SeerLikeJazz/Libuart-peripheral-EEG/(threads)

Thread 1 (2024-11-12):

Request to add PCB designs

xinterface, 2024-11-12:
Hi 👋,
I recently came across your project and wanted to ask if you’d be able to share the PCB design in the same folder. If possible, could you also let me know which software you used? And if you still have the project files, would you mind adding those too?

I’m currently learning KiCad—still getting the hang of it, but making progress!

If you have some time to connect in the future, I would love to chat with you about your project.

Thank you so much! ✌️
