SeerLikeJazz/Libuart-peripheral-EEG/Hardware/Schematic_nrf52832_2022-09-26.pdf

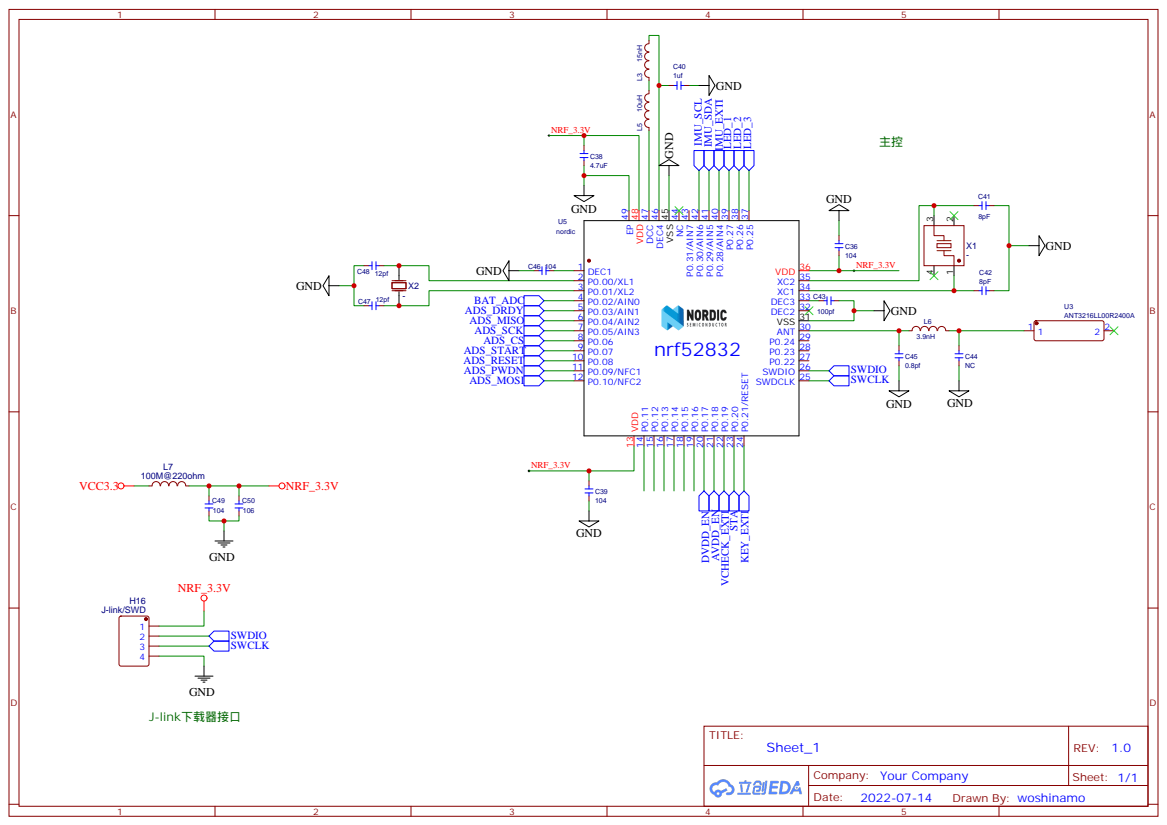
[picture p6: page 1]

P0.25 37 P0.26 38 P0.27 39 P0.28/AIN4 40 P0.29/AIN5 41 P0.30/AIN6 42 P0.31/AIN7 43 NC 44 VSS 45 DEC4 46 DCC 47 VDD 48 EP 49

# Vcheck画错了，应该是接入5V

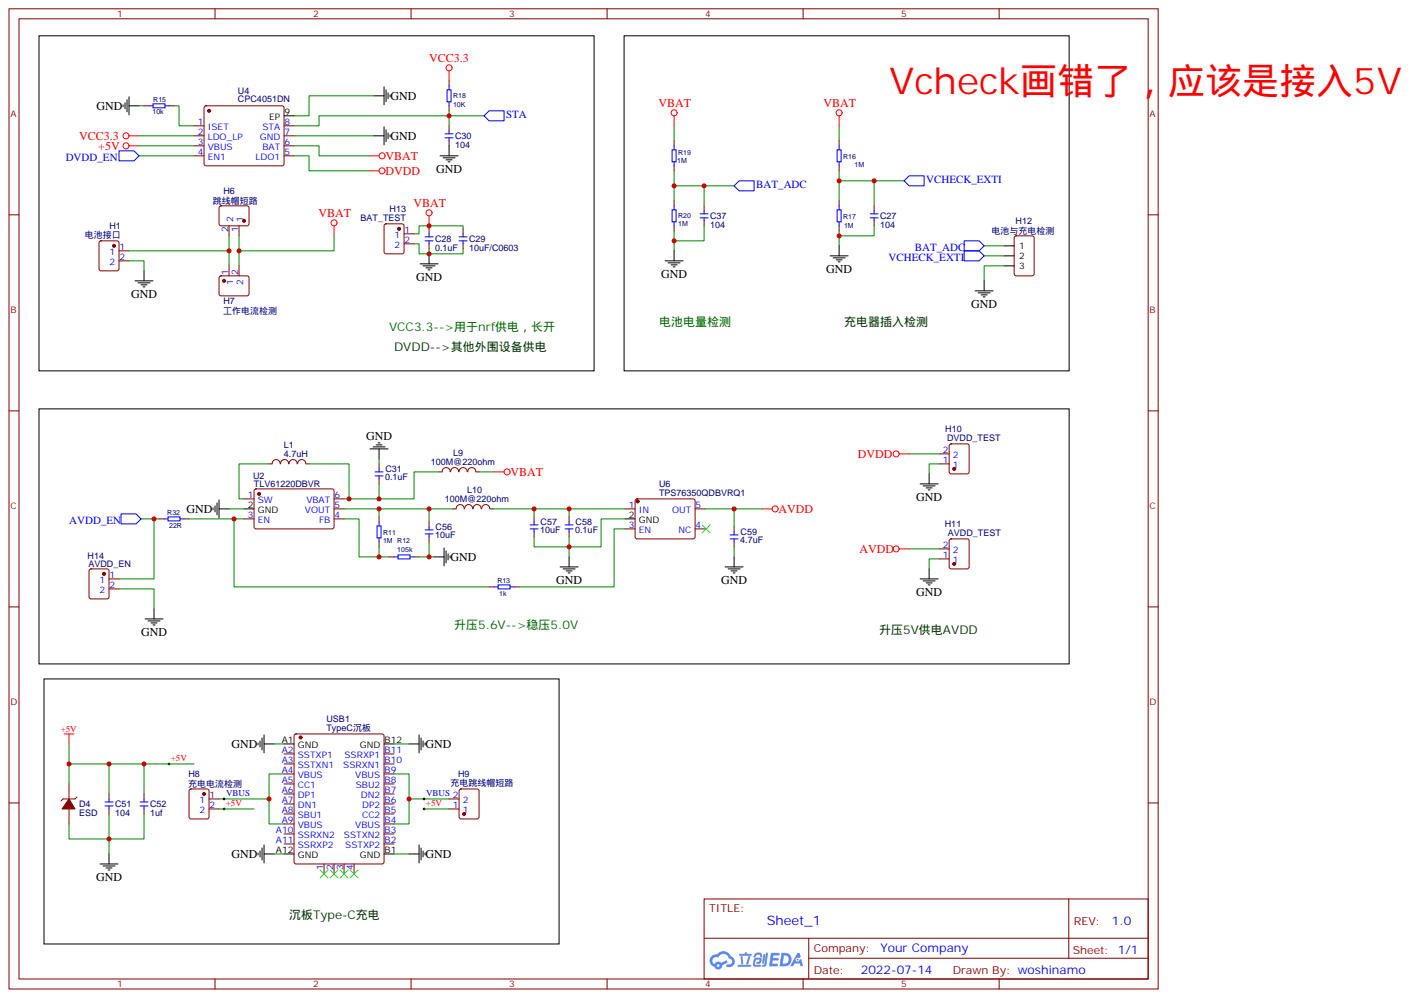
[picture p7: page 2]

GND B1 GND A12 SSRXP2 A11 SSRXN2 A10 VBUS A9 SBU1 A8 DN1 A7 DP1 A6 CC1 A5 VBUS A4 SSTXN1 A3 SSTXP1 A2 GND A1

AVSS 32 DGND 33 DIN 34 PWDN# 35 RESET# 36 CLK 37 START 38 CS# 39 SCLK 40 DAISY_IN 41 GPIO1 42 DOUT 43 GPIO2 44 GPIO3 45 GPIO4 46 DRDY# 47 DVDD 48 DGND 49 DVDD 50 DGND 51 CLKSEL 52 AVSS1 53 AVDD1 54 VCAP3 55 AVDD 56 AVSS 57 AVSS 58 AVDD 59 BIASREF 60 BIASINV 61 BIASIN 62 BIASOUT 63 RESERVED 64

## BIASINV BIASIN-->Filter or FeedThrough -->BIASOUT

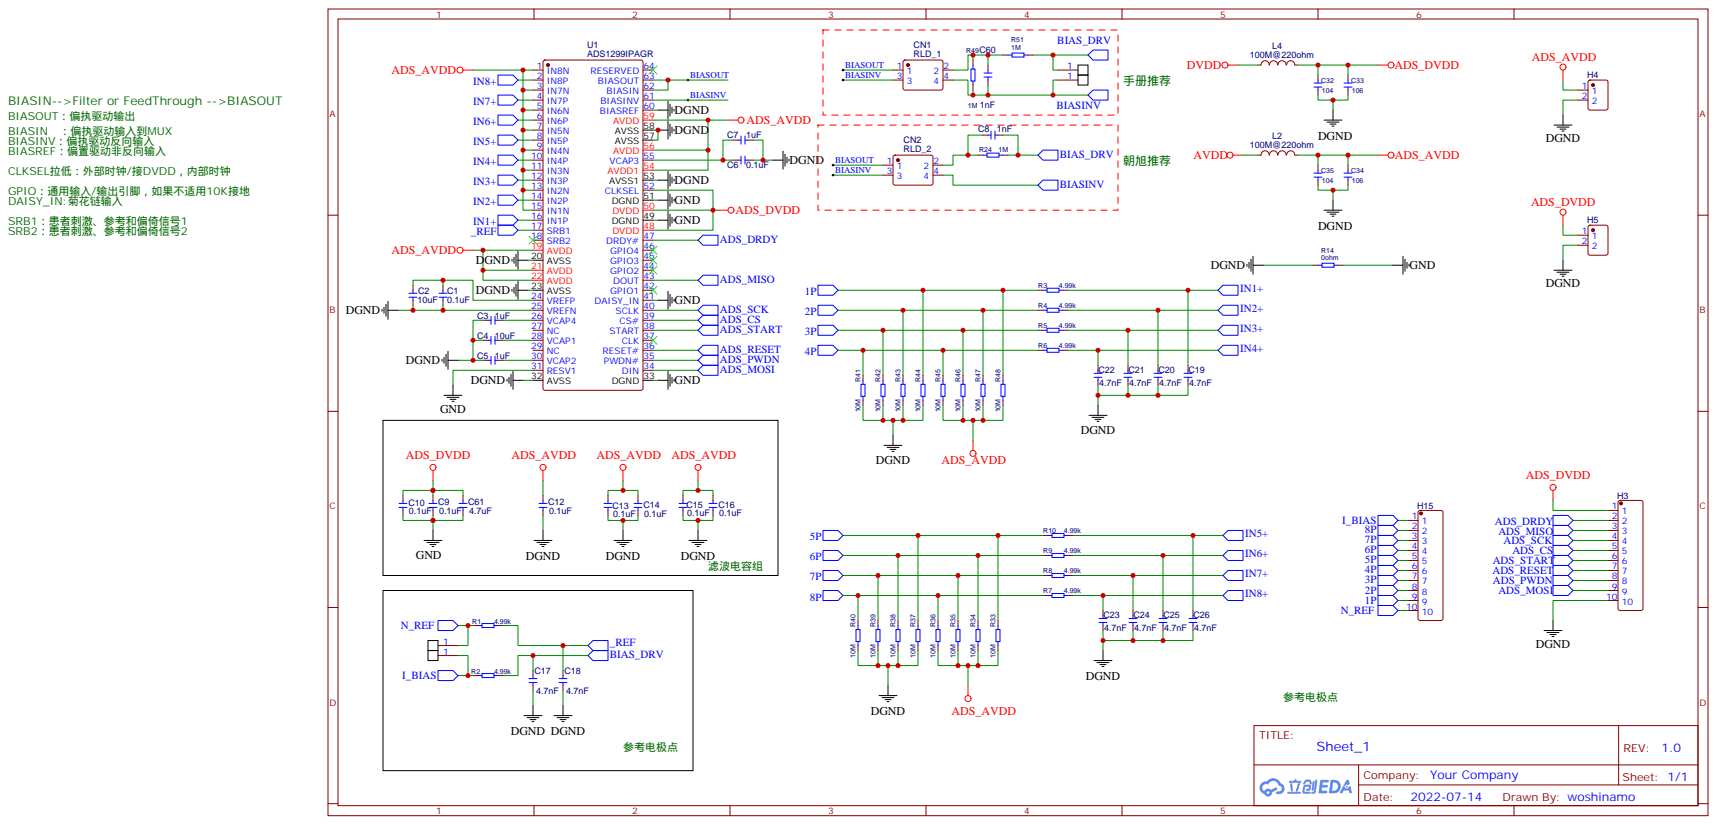
[picture p8: page 3]

## IMU更换 去掉MPU6050 更换为ST家的LSM6DSLTR

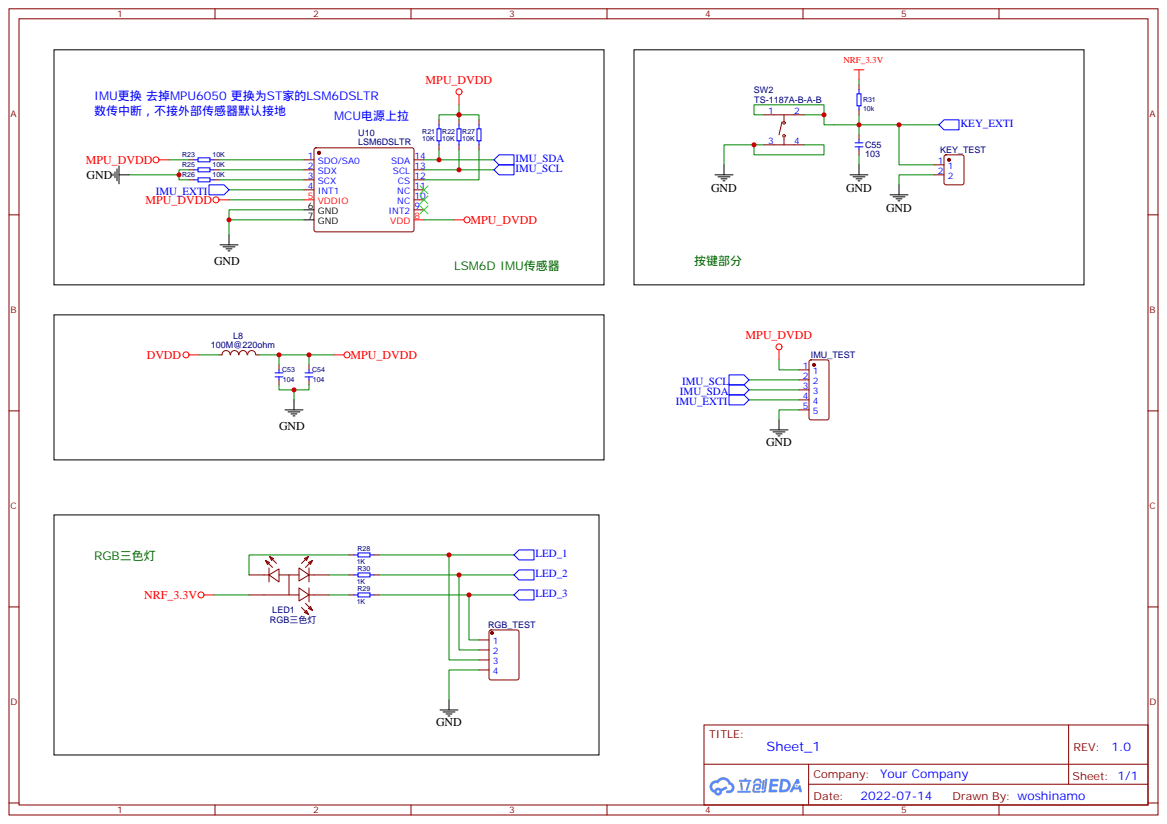
[picture p9: page 4]
