SeerLikeJazz/Libuart-peripheral-EEG/接收信号强度rssi和蓝牙发射功率/components/ble/ble_services/ble_nus/ble_nus.c

/**
 * Copyright (c) 2012 - 2020, Nordic Semiconductor ASA
 *
 * All rights reserved.
 *
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
 * 3. Neither the name of Nordic Semiconductor ASA nor the names of its
 *    contributors may be used to endorse or promote products derived from this
 *    software without specific prior written permission.
 *
 * 4. This software, with or without modification, must only be used with a
 *    Nordic Semiconductor ASA integrated circuit.
 *
 * 5. Any software provided in binary form under this license must not be reverse
 *    engineered, decompiled, modified and/or disassembled.
 *
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
 */
#include "sdk_common.h"
#if NRF_MODULE_ENABLED(BLE_NUS)
#include "ble.h"
#include "ble_nus.h"
#include "ble_srv_common.h"

#define NRF_LOG_MODULE_NAME ble_nus
#if BLE_NUS_CONFIG_LOG_ENABLED
#define NRF_LOG_LEVEL       BLE_NUS_CONFIG_LOG_LEVEL
#define NRF_LOG_INFO_COLOR  BLE_NUS_CONFIG_INFO_COLOR
#define NRF_LOG_DEBUG_COLOR BLE_NUS_CONFIG_DEBUG_COLOR
#else // BLE_NUS_CONFIG_LOG_ENABLED
#define NRF_LOG_LEVEL       0
#endif // BLE_NUS_CONFIG_LOG_ENABLED
#include "nrf_log.h"
NRF_LOG_MODULE_REGISTER();


#define BLE_UUID_NUS_TX_CHARACTERISTIC 0x0003               /**< The UUID of the TX Characteristic. */
#define BLE_UUID_NUS_RX_CHARACTERISTIC 0x0002               /**< The UUID of the RX Characteristic. */

#define BLE_NUS_MAX_RX_CHAR_LEN        BLE_NUS_MAX_DATA_LEN /**< Maximum length of the RX Characteristic (in bytes). */
#define BLE_NUS_MAX_TX_CHAR_LEN        BLE_NUS_MAX_DATA_LEN /**< Maximum length of the TX Characteristic (in bytes). */

#define NUS_BASE_UUID                  {{0x9E, 0xCA, 0xDC, 0x24, 0x0E, 0xE5, 0xA9, 0xE0, 0x93, 0xF3, 0xA3, 0xB5, 0x00, 0x00, 0x40, 0x6E}} /**< Used vendor specific UUID. */


/**@brief Function for handling the @ref BLE_GAP_EVT_CONNECTED event from the SoftDevice.发送连接事件后，本服务做的工作
 *
 * @param[in] p_nus     Nordic UART Service structure.
 * @param[in] p_ble_evt Pointer to the event received from BLE stack.
 */
static void on_connect(ble_nus_t * p_nus, ble_evt_t const * p_ble_evt)
{
    ret_code_t                 err_code;
    ble_nus_evt_t              evt;
    ble_gatts_value_t          gatts_val;
    uint8_t                    cccd_value[2];
    ble_nus_client_context_t * p_client = NULL;

    err_code = blcm_link_ctx_get(p_nus->p_link_ctx_storage,
                                 p_ble_evt->evt.gap_evt.conn_handle,
                                 (void *) &p_client);//分派连接句柄空间
    if (err_code != NRF_SUCCESS)
    {
        NRF_LOG_ERROR("Link context for 0x%02X connection handle could not be fetched.",
                      p_ble_evt->evt.gap_evt.conn_handle);
    }

    /* Check the hosts CCCD value to inform of readiness to send data using the RX characteristic 
		检查主机CCCD值，通知准备发送数据，使用RX特征*/
    memset(&gatts_val, 0, sizeof(ble_gatts_value_t));
    gatts_val.p_value = cccd_value;
    gatts_val.len     = sizeof(cccd_value);
    gatts_val.offset  = 0;

    err_code = sd_ble_gatts_value_get(p_ble_evt->evt.gap_evt.conn_handle,
                                      p_nus->tx_handles.cccd_handle,
                                      &gatts_val);//获取CCCD的值

    if ((err_code == NRF_SUCCESS)     &&
        (p_nus->data_handler != NULL) &&
        ble_srv_is_notification_enabled(gatts_val.p_value))
    {
        if (p_client != NULL)
        {
            p_client->is_notification_enabled = true;//使能了从机通知
        }

        memset(&evt, 0, sizeof(ble_nus_evt_t));
        evt.type        = BLE_NUS_EVT_COMM_STARTED;//通信开始事件
        evt.p_nus       = p_nus;
        evt.conn_handle = p_ble_evt->evt.gap_evt.conn_handle;//分派事件句柄
        evt.p_link_ctx  = p_client;

        p_nus->data_handler(&evt);
    }
}


/**@brief Function for handling the @ref BLE_GATTS_EVT_WRITE event from the SoftDevice.
 *
 * @param[in] p_nus     Nordic UART Service structure.
 * @param[in] p_ble_evt Pointer to the event received from BLE stack.
 */
static void on_write(ble_nus_t * p_nus, ble_evt_t const * p_ble_evt)
{
    ret_code_t                    err_code;
    ble_nus_evt_t                 evt;
    ble_nus_client_context_t    * p_client;
    ble_gatts_evt_write_t const * p_evt_write = &p_ble_evt->evt.gatts_evt.params.write;

    err_code = blcm_link_ctx_get(p_nus->p_link_ctx_storage,
                                 p_ble_evt->evt.gatts_evt.conn_handle,
                                 (void *) &p_client);
    if (err_code != NRF_SUCCESS)
    {
        NRF_LOG_ERROR("Link context for 0x%02X connection handle could not be fetched.",
                      p_ble_evt->evt.gatts_evt.conn_handle);
    }

    memset(&evt, 0, sizeof(ble_nus_evt_t));
    evt.p_nus       = p_nus;
    evt.conn_handle = p_ble_evt->evt.gatts_evt.conn_handle;
    evt.p_link_ctx  = p_client;

    if ((p_evt_write->handle == p_nus->tx_handles.cccd_handle) &&
        (p_evt_write->len == 2))///如果是主机通知使能
    {
        if (p_client != NULL)
        {
            if (ble_srv_is_notification_enabled(p_evt_write->data))
            {
                p_client->is_notification_enabled = true;
                evt.type                          = BLE_NUS_EVT_COMM_STARTED;
            }
            else
            {
                p_client->is_notification_enabled = false;
                evt.type                          = BLE_NUS_EVT_COMM_STOPPED;
            }

            if (p_nus->data_handler != NULL)
            {
                p_nus->data_handler(&evt);
            }

        }
    }
    else if ((p_evt_write->handle == p_nus->rx_handles.value_handle) &&
             (p_nus->data_handler != NULL))//如果是主机写数据给从机
    {
        evt.type                  = BLE_NUS_EVT_RX_DATA;//主机写数据给从机
        evt.params.rx_data.p_data = p_evt_write->data;
        evt.params.rx_data.length = p_evt_write->len;

        p_nus->data_handler(&evt);
    }
    else
    {
        // Do Nothing. This event is not relevant for this service.
    }
}


/**@brief Function for handling the @ref BLE_GATTS_EVT_HVN_TX_COMPLETE event from the SoftDevice.
 *
 * @param[in] p_nus     Nordic UART Service structure.
 * @param[in] p_ble_evt Pointer to the event received from BLE stack.
 */
static void on_hvx_tx_complete(ble_nus_t * p_nus, ble_evt_t const * p_ble_evt)
{
    ret_code_t                 err_code;
    ble_nus_evt_t              evt;
    ble_nus_client_context_t * p_client;

    err_code = blcm_link_ctx_get(p_nus->p_link_ctx_storage,
                                 p_ble_evt->evt.gatts_evt.conn_handle,
                                 (void *) &p_client);
    if (err_code != NRF_SUCCESS)
    {
        NRF_LOG_ERROR("Link context for 0x%02X connection handle could not be fetched.",
                      p_ble_evt->evt.gatts_evt.conn_handle);
        return;
    }

    if ((p_client->is_notification_enabled) && (p_nus->data_handler != NULL))//如果主机通知使能，并且数据不为null
    {
        memset(&evt, 0, sizeof(ble_nus_evt_t));
        evt.type        = BLE_NUS_EVT_TX_RDY;//服务已准备好接受要传输的新数据
        evt.p_nus       = p_nus;
        evt.conn_handle = p_ble_evt->evt.gatts_evt.conn_handle;
        evt.p_link_ctx  = p_client;

        p_nus->data_handler(&evt);
    }
}

//串口事件派发函数
void ble_nus_on_ble_evt(ble_evt_t const * p_ble_evt, void * p_context)
{
    if ((p_context == NULL) || (p_ble_evt == NULL))
    {
        return;
    }

    ble_nus_t * p_nus = (ble_nus_t *)p_context;

    switch (p_ble_evt->header.evt_id)
    {
        case BLE_GAP_EVT_CONNECTED://连接的时候
            on_connect(p_nus, p_ble_evt);
            break;

        case BLE_GATTS_EVT_WRITE://写的时候
            on_write(p_nus, p_ble_evt);
            break;

        case BLE_GATTS_EVT_HVN_TX_COMPLETE://发送完成的时候
            on_hvx_tx_complete(p_nus, p_ble_evt);
            break;

        default:
            // No implementation needed.
            break;
    }
}


uint32_t ble_nus_init(ble_nus_t * p_nus, ble_nus_init_t const * p_nus_init)
{
    ret_code_t            err_code;
    ble_uuid_t            ble_uuid;
    ble_uuid128_t         nus_base_uuid = NUS_BASE_UUID;
    ble_add_char_params_t add_char_params;

    VERIFY_PARAM_NOT_NULL(p_nus);
    VERIFY_PARAM_NOT_NULL(p_nus_init);

    // 初始化服务数据句柄
    p_nus->data_handler = p_nus_init->data_handler;

    /**@snippet [Adding proprietary Service to the SoftDevice] */
    // 添加基础UUID
    err_code = sd_ble_uuid_vs_add(&nus_base_uuid, &p_nus->uuid_type);
    VERIFY_SUCCESS(err_code);
	
   //添加主服务UUID
    ble_uuid.type = p_nus->uuid_type;
    ble_uuid.uuid = BLE_UUID_NUS_SERVICE;
    // Add the service.
    err_code = sd_ble_gatts_service_add(BLE_GATTS_SRVC_TYPE_PRIMARY,
                                        &ble_uuid,
                                        &p_nus->service_handle);
    /**@snippet [Adding proprietary Service to the SoftDevice] */
    VERIFY_SUCCESS(err_code);

    // 添加RX特性
    memset(&add_char_params, 0, sizeof(add_char_params));
    add_char_params.uuid                     = BLE_UUID_NUS_RX_CHARACTERISTIC;//特性UUID
    add_char_params.uuid_type                = p_nus->uuid_type;//UUID类型
    add_char_params.max_len                  = BLE_NUS_MAX_RX_CHAR_LEN;//最大的数据长度
    add_char_params.init_len                 = sizeof(uint8_t);//初始化数据长度
    add_char_params.is_var_len               = true;//可变数据长度
    add_char_params.char_props.write         = 1;//写属性
    add_char_params.char_props.write_wo_resp = 1;//没有回复的写

    add_char_params.read_access  = SEC_OPEN;//安全级别
    add_char_params.write_access = SEC_OPEN;

    err_code = characteristic_add(p_nus->service_handle, &add_char_params, &p_nus->rx_handles);
    if (err_code != NRF_SUCCESS)
    {
        return err_code;
    }

    // 添加TX特性
    /**@snippet [Adding proprietary characteristic to the SoftDevice] */
    memset(&add_char_params, 0, sizeof(add_char_params));
    add_char_params.uuid              = BLE_UUID_NUS_TX_CHARACTERISTIC;//特性UUID
    add_char_params.uuid_type         = p_nus->uuid_type;//UUID类型
    add_char_params.max_len           = BLE_NUS_MAX_TX_CHAR_LEN;//最大数据长度
    add_char_params.init_len          = sizeof(uint8_t);//初始化长度
    add_char_params.is_var_len        = true;//数据长度可变
    add_char_params.char_props.notify = 1;//通知

    add_char_params.read_access       = SEC_OPEN; 
    add_char_params.write_access      = SEC_OPEN;
    add_char_params.cccd_write_access = SEC_OPEN;//主机描述符

    return characteristic_add(p_nus->service_handle, &add_char_params, &p_nus->tx_handles);
    /**@snippet [Adding proprietary characteristic to the SoftDevice] */
}


uint32_t ble_nus_data_send(ble_nus_t * p_nus,
                           uint8_t   * p_data,
                           uint16_t  * p_length,
                           uint16_t    conn_handle)//从机通知上传数据给主机
{
    ret_code_t                 err_code;
    ble_gatts_hvx_params_t     hvx_params;
    ble_nus_client_context_t * p_client;

    VERIFY_PARAM_NOT_NULL(p_nus);

    err_code = blcm_link_ctx_get(p_nus->p_link_ctx_storage, conn_handle, (void *) &p_client);
    VERIFY_SUCCESS(err_code);

    if ((conn_handle == BLE_CONN_HANDLE_INVALID) || (p_client == NULL))
    {
        return NRF_ERROR_NOT_FOUND;
    }

    if (!p_client->is_notification_enabled)
    {
        return NRF_ERROR_INVALID_STATE;
    }

    if (*p_length > BLE_NUS_MAX_DATA_LEN)
    {
        return NRF_ERROR_INVALID_PARAM;
    }

    memset(&hvx_params, 0, sizeof(hvx_params));

    hvx_params.handle = p_nus->tx_handles.value_handle;
    hvx_params.p_data = p_data;
    hvx_params.p_len  = p_length;
    hvx_params.type   = BLE_GATT_HVX_NOTIFICATION;

    return sd_ble_gatts_hvx(conn_handle, &hvx_params);
}


#endif // NRF_MODULE_ENABLED(BLE_NUS)
