SeerLikeJazz/Libuart-peripheral-EEG/Firmware/USER/data_struct.h

#ifndef  _DATA_STRUCT_H_
#define  _DATA_STRUCT_H_

#include "stdint.h"
#include "stdbool.h"

typedef struct
{

bool adv_started;   //用来标记是否广播



}DEVICE_PARA;



void Device_Para_Init(DEVICE_PARA *dvicepara);




#endif
