SeerLikeJazz/Libuart-peripheral-EEG/Firmware/examples/ble_peripheral/ble_app_uart/main.c

/**
 * Copyright (c) 2014 - 2021, Nordic Semiconductor ASA
 *
 * All rights reserved.
 *
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
 * 3. Neither the name of Nordic Semiconductor ASA nor the names of its
 *    contributors may be used to endorse or promote products derived from this
 *    software without specific prior written permission.
 *
 * 4. This software, with or without modification, must only be used with a
 *    Nordic Semiconductor ASA integrated circuit.
 *
 * 5. Any software provided in binary form under this license must not be reverse
 *    engineered, decompiled, modified and/or disassembled.
 *
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
 */
/** @file
 *
 * @defgroup ble_sdk_uart_over_ble_main main.c
 * @{
 * @ingroup  ble_sdk_app_nus_eval
 * @brief    UART over BLE application main file.
 *
 * This file contains the source code for a sample application that uses the Nordic UART service.
 * This application uses the @ref srvlib_conn_params module.
 */

#include <stdbool.h>
#include <stdint.h>
#include <string.h>
#include "nordic_common.h"
#include "nrf.h"
#include "ble_hci.h"
#include "ble_advdata.h"
#include "ble_advertising.h"
#include "ble_conn_params.h"
#include "nrf_sdh.h"
#include "nrf_sdh_soc.h"
#include "nrf_sdh_ble.h"
#include "nrf_ble_gatt.h"
#include "nrf_ble_qwr.h"
#include "app_timer.h"
#include "ble_nus.h"
#include "app_uart.h"
#include "app_util_platform.h"
#include "bsp_btn_ble.h"
#include "nrf_pwr_mgmt.h"

#include "nrf_dfu_ble_svci_bond_sharing.h"
#include "nrf_svci_async_function.h"
#include "nrf_svci_async_handler.h"

#include "app_error.h"
#include "ble.h"
#include "ble_srv_common.h"

#include "peer_manager.h"
#include "peer_manager_handler.h"

#include "ble_conn_state.h"
#include "ble_dfu.h"

#include "fds.h"
#include "nrf_drv_clock.h"
#include "nrf_power.h"
#include "nrf_bootloader_info.h"


#if defined (UART_PRESENT)
#include "nrf_uart.h"
#endif
#if defined (UARTE_PRESENT)
#include "nrf_uarte.h"
#endif

#include "nrf_log.h"
#include "nrf_log_ctrl.h"
#include "nrf_log_default_backends.h"
#include "pca10040.h"
#include "nrf_delay.h"


#include "nrf_queue.h"
#include "nrf_drv_gpiote.h"

#include "ADS1299_Library.h"
#include "driver_power.h"

#include "data_struct.h"

#define APP_BLE_CONN_CFG_TAG            1                                           /**< A tag identifying the SoftDevice BLE configuration. */

#define DEVICE_NAME                     "SeerLikeJazz"                               /**< Name of device. Will be included in the advertising data. */
#define NUS_SERVICE_UUID_TYPE           BLE_UUID_TYPE_VENDOR_BEGIN                  /**< UUID type for the Nordic UART Service (vendor specific). */

#define APP_BLE_OBSERVER_PRIO           3                                           /**< Application's BLE observer priority. You shouldn't need to modify this value. */

#define APP_ADV_INTERVAL                64                                          /**< The advertising interval (in units of 0.625 ms. This value corresponds to 40 ms). */

#define APP_ADV_DURATION                0                                       /**< The advertising duration (180 seconds) in units of 10 milliseconds. */

#define MIN_CONN_INTERVAL               MSEC_TO_UNITS(20, UNIT_1_25_MS)             /**< Minimum acceptable connection interval (20 ms), Connection interval uses 1.25 ms units. */
#define MAX_CONN_INTERVAL               MSEC_TO_UNITS(20, UNIT_1_25_MS)             /**< Maximum acceptable connection interval (75 ms), Connection interval uses 1.25 ms units. */
#define SLAVE_LATENCY                   0                                           /**< Slave latency. */
#define CONN_SUP_TIMEOUT                MSEC_TO_UNITS(4000, UNIT_10_MS)             /**< Connection supervisory timeout (4 seconds), Supervision Timeout uses 10 ms units. */
#define FIRST_CONN_PARAMS_UPDATE_DELAY  APP_TIMER_TICKS(5000)                       /**< Time from initiating event (connect or start of notification) to first time sd_ble_gap_conn_param_update is called (5 seconds). */
#define NEXT_CONN_PARAMS_UPDATE_DELAY   APP_TIMER_TICKS(30000)                      /**< Time between each call to sd_ble_gap_conn_param_update after the first call (30 seconds). */
#define MAX_CONN_PARAMS_UPDATE_COUNT    3                                           /**< Number of attempts before giving up the connection parameter negotiation. */


#define SEC_PARAM_BOND                  1                                           /**< Perform bonding. */
#define SEC_PARAM_MITM                  0                                           /**< Man In The Middle protection not required. */
#define SEC_PARAM_LESC                  0                                           /**< LE Secure Connections not enabled. */
#define SEC_PARAM_KEYPRESS              0                                           /**< Keypress notifications not enabled. */
#define SEC_PARAM_IO_CAPABILITIES       BLE_GAP_IO_CAPS_NONE                        /**< No I/O capabilities. */
#define SEC_PARAM_OOB                   0                                           /**< Out Of Band data not available. */
#define SEC_PARAM_MIN_KEY_SIZE          7                                           /**< Minimum encryption key size. */
#define SEC_PARAM_MAX_KEY_SIZE          16                                          /**< Maximum encryption key size. */


#define DEAD_BEEF                       0xDEADBEEF                                  /**< Value used as error code on stack dump, can be used to identify stack location on stack unwind. */

#define UART_TX_BUF_SIZE                256                                         /**< UART TX buffer size. */
#define UART_RX_BUF_SIZE                256                                         /**< UART RX buffer size. */


BLE_NUS_DEF(m_nus, NRF_SDH_BLE_TOTAL_LINK_COUNT);                                   /**< BLE NUS service instance. */
NRF_BLE_GATT_DEF(m_gatt);                                                           /**< GATT module instance. */
NRF_BLE_QWR_DEF(m_qwr);                                                             /**< Context for the Queued Write module.*/
BLE_ADVERTISING_DEF(m_advertising);                                                 /**< Advertising module instance. */

static uint16_t   m_conn_handle          = BLE_CONN_HANDLE_INVALID;                 /**< Handle of the current connection. */
static uint16_t   m_ble_nus_max_data_len = BLE_GATT_ATT_MTU_DEFAULT - 3;            /**< Maximum length of data (in bytes) that can be transmitted to the peer by the Nordic UART service module. */
static ble_uuid_t m_adv_uuids[]          =                                          /**< Universally unique service identifier. */
{
    {BLE_UUID_NUS_SERVICE, NUS_SERVICE_UUID_TYPE}
};


/**
**数据缓存队列相关
**/
void ble_data_send_with_queue(void);
typedef struct {
    uint8_t * p_data;
    uint16_t length;
} buffer_t;

NRF_QUEUE_DEF(buffer_t, m_buf_queue, 30, NRF_QUEUE_MODE_NO_OVERFLOW);

APP_TIMER_DEF(m_timer_speed);
uint8_t m_data_array[220*30];
uint32_t m_len_sent;
uint32_t m_cnt_7ms;

//充电用定时器
APP_TIMER_DEF(charging_timer);
//系统检测用定时器（指令是否更新）
APP_TIMER_DEF(system_task_timer);
//全局参数
DEVICE_PARA DevicePara;   



/**@brief Function for assert macro callback.
 *
 * @details This function will be called in case of an assert in the SoftDevice.
 *
 * @warning This handler is an example only and does not fit a final product. You need to analyse
 *          how your product is supposed to react in case of Assert.
 * @warning On assert from the SoftDevice, the system can only recover on reset.
 *
 * @param[in] line_num    Line number of the failing ASSERT call.
 * @param[in] p_file_name File name of the failing ASSERT call.
 */
void assert_nrf_callback(uint16_t line_num, const uint8_t * p_file_name)
{
    app_error_handler(DEAD_BEEF, line_num, p_file_name);
}



/**@brief Function for the GAP initialization.
 *
 * @details This function will set up all the necessary GAP (Generic Access Profile) parameters of
 *          the device. It also sets the permissions and appearance.
 */
static void gap_params_init(void)
{
    uint32_t                err_code;
    ble_gap_conn_params_t   gap_conn_params;
    ble_gap_conn_sec_mode_t sec_mode;

    BLE_GAP_CONN_SEC_MODE_SET_OPEN(&sec_mode);

    err_code = sd_ble_gap_device_name_set(&sec_mode,
                                          (const uint8_t *) DEVICE_NAME,
                                          strlen(DEVICE_NAME));
    APP_ERROR_CHECK(err_code);

    memset(&gap_conn_params, 0, sizeof(gap_conn_params));

    gap_conn_params.min_conn_interval = MIN_CONN_INTERVAL;
    gap_conn_params.max_conn_interval = MAX_CONN_INTERVAL;
    gap_conn_params.slave_latency     = SLAVE_LATENCY;
    gap_conn_params.conn_sup_timeout  = CONN_SUP_TIMEOUT;

    err_code = sd_ble_gap_ppcp_set(&gap_conn_params);
    APP_ERROR_CHECK(err_code);
}


/**@brief Function for handling Queued Write Module errors.
 *
 * @details A pointer to this function will be passed to each service which may need to inform the
 *          application about an error.
 *
 * @param[in]   nrf_error   Error code containing information about what went wrong.
 */
static void nrf_qwr_error_handler(uint32_t nrf_error)
{
    APP_ERROR_HANDLER(nrf_error);
}




/**@brief Function for handling the data from the Nordic UART Service.
 *
 * @details This function will process the data received from the Nordic UART BLE Service and send
 *          it to the UART module.
 *
 * @param[in] p_evt       Nordic UART Service event.
 */
/**@snippet [Handling the data received over BLE] */
uint8_t RXbuff[10];
static void nus_data_handler(ble_nus_evt_t * p_evt)
{
    if (p_evt->type == BLE_NUS_EVT_RX_DATA)
    {
        NRF_LOG_DEBUG("Received data from BLE NUS. Writing data on UART.");
        NRF_LOG_HEXDUMP_DEBUG(p_evt->params.rx_data.p_data, p_evt->params.rx_data.length);
				if(p_evt->params.rx_data.length < 10) {//防止接收数组超出范围
					for (uint32_t i = 0; i < p_evt->params.rx_data.length; i++)
					{
						RXbuff[i] = p_evt->params.rx_data.p_data[i];
					}
				}
    }
		else if (p_evt->type == BLE_NUS_EVT_COMM_STARTED)
		{
//			APP_ERROR_CHECK(app_timer_start(m_timer_speed, APP_TIMER_TICKS(20),NULL));			
		}
		else if (p_evt->type == BLE_NUS_EVT_TX_RDY)
		{
      ble_data_send_with_queue();
		}

}
/**@snippet [Handling the data received over BLE] */


/*DFU新增*/

// YOUR_JOB: Update this code if you want to do anything given a DFU event (optional).
/**@brief Function for handling dfu events from the Buttonless Secure DFU service
 *
 * @param[in]   event   Event from the Buttonless Secure DFU service.
 */
static void ble_dfu_evt_handler(ble_dfu_buttonless_evt_type_t event)
{
    switch (event)
    {
        case BLE_DFU_EVT_BOOTLOADER_ENTER_PREPARE:
            NRF_LOG_INFO("Device is preparing to enter bootloader mode.");
            // YOUR_JOB: Disconnect all bonded devices that currently are connected.
            //           This is required to receive a service changed indication
            //           on bootup after a successful (or aborted) Device Firmware Update.
            break;

        case BLE_DFU_EVT_BOOTLOADER_ENTER:
            // YOUR_JOB: Write app-specific unwritten data to FLASH, control finalization of this
            //           by delaying reset by reporting false in app_shutdown_handler
            NRF_LOG_INFO("Device will enter bootloader mode.");
            break;

        case BLE_DFU_EVT_BOOTLOADER_ENTER_FAILED:
            NRF_LOG_ERROR("Request to enter bootloader mode failed asynchroneously.");
            // YOUR_JOB: Take corrective measures to resolve the issue
            //           like calling APP_ERROR_CHECK to reset the device.
            break;

        case BLE_DFU_EVT_RESPONSE_SEND_ERROR:
            NRF_LOG_ERROR("Request to send a response to client failed.");
            // YOUR_JOB: Take corrective measures to resolve the issue
            //           like calling APP_ERROR_CHECK to reset the device.
            APP_ERROR_CHECK(false);
            break;

        default:
            NRF_LOG_ERROR("Unknown event from ble_dfu_buttonless.");
            break;
    }
}

#if(DFU_MODE_ENABLE)
static void user_dfu_init(void)
{
  uint32_t           err_code;	
  ble_dfu_buttonless_init_t dfus_init = {0};
    // Initialize the async SVCI interface to bootloader before any interrupts are enabled.
    err_code = ble_dfu_buttonless_async_svci_init();	
    dfus_init.evt_handler = ble_dfu_evt_handler;
    err_code = ble_dfu_buttonless_init(&dfus_init);
    APP_ERROR_CHECK(err_code);
}
#endif

/**@brief Function for initializing services that will be used by the application.
 */
static void services_init(void)
{
    uint32_t           err_code;
    ble_nus_init_t     nus_init;
    nrf_ble_qwr_init_t qwr_init = {0};

    // Initialize Queued Write Module.
    qwr_init.error_handler = nrf_qwr_error_handler;

    err_code = nrf_ble_qwr_init(&m_qwr, &qwr_init);
    APP_ERROR_CHECK(err_code);

    // Initialize NUS.
    memset(&nus_init, 0, sizeof(nus_init));

    nus_init.data_handler = nus_data_handler;

    err_code = ble_nus_init(&m_nus, &nus_init);
    APP_ERROR_CHECK(err_code);
		
		//Initialize DFU
		#if(DFU_MODE_ENABLE)
		user_dfu_init();
		#endif
}


/**@brief Function for handling an event from the Connection Parameters Module.
 *
 * @details This function will be called for all events in the Connection Parameters Module
 *          which are passed to the application.
 *
 * @note All this function does is to disconnect. This could have been done by simply setting
 *       the disconnect_on_fail config parameter, but instead we use the event handler
 *       mechanism to demonstrate its use.
 *
 * @param[in] p_evt  Event received from the Connection Parameters Module.
 */
static void on_conn_params_evt(ble_conn_params_evt_t * p_evt)
{
    uint32_t err_code;

    if (p_evt->evt_type == BLE_CONN_PARAMS_EVT_FAILED)
    {
        err_code = sd_ble_gap_disconnect(m_conn_handle, BLE_HCI_CONN_INTERVAL_UNACCEPTABLE);
        APP_ERROR_CHECK(err_code);
    }
}


/**@brief Function for handling errors from the Connection Parameters module.
 *
 * @param[in] nrf_error  Error code containing information about what went wrong.
 */
static void conn_params_error_handler(uint32_t nrf_error)
{
    APP_ERROR_HANDLER(nrf_error);
}


/**@brief Function for initializing the Connection Parameters module.
 */
static void conn_params_init(void)
{
    uint32_t               err_code;
    ble_conn_params_init_t cp_init;

    memset(&cp_init, 0, sizeof(cp_init));

    cp_init.p_conn_params                  = NULL;
    cp_init.first_conn_params_update_delay = FIRST_CONN_PARAMS_UPDATE_DELAY;
    cp_init.next_conn_params_update_delay  = NEXT_CONN_PARAMS_UPDATE_DELAY;
    cp_init.max_conn_params_update_count   = MAX_CONN_PARAMS_UPDATE_COUNT;
    cp_init.start_on_notify_cccd_handle    = BLE_GATT_HANDLE_INVALID;
    cp_init.disconnect_on_fail             = false;
    cp_init.evt_handler                    = on_conn_params_evt;
    cp_init.error_handler                  = conn_params_error_handler;

    err_code = ble_conn_params_init(&cp_init);
    APP_ERROR_CHECK(err_code);
}


/**@brief Function for putting the chip into sleep mode.
 *
 * @note This function will not return.
 */
static void sleep_mode_enter(void)
{
    uint32_t err_code = bsp_indication_set(BSP_INDICATE_IDLE);
    APP_ERROR_CHECK(err_code);
	
		//关闭耗电的部分
		prepare_before_sleep();
	
		//准备充电器接入唤醒
		nrf_gpio_cfg_sense_set(CHARGE_VCHECK_PIN,NRF_GPIO_PIN_SENSE_HIGH);		//充电器接入高电平触发->唤醒
    // Prepare wakeup buttons.
    err_code = bsp_btn_ble_sleep_mode_prepare();
    APP_ERROR_CHECK(err_code);

    // Go to system-off mode (this function will not return; wakeup will cause a reset).
    err_code = sd_power_system_off();
    APP_ERROR_CHECK(err_code);
}


/**@brief Function for handling advertising events.
 *
 * @details This function will be called for advertising events which are passed to the application.
 *
 * @param[in] ble_adv_evt  Advertising event.
 */
static void on_adv_evt(ble_adv_evt_t ble_adv_evt)
{
    uint32_t err_code;

    switch (ble_adv_evt)
    {
        case BLE_ADV_EVT_FAST:
            err_code = bsp_indication_set(BSP_INDICATE_ADVERTISING);
            APP_ERROR_CHECK(err_code);
						DevicePara.adv_started = true;
            break;
        case BLE_ADV_EVT_IDLE:
            sleep_mode_enter();
            break;
        default:
            break;
    }
}


/**@brief Function for handling BLE events.
 *
 * @param[in]   p_ble_evt   Bluetooth stack event.
 * @param[in]   p_context   Unused.
 */
  ble_gap_phys_t const phys =
            {
                .rx_phys = BLE_GAP_PHY_2MBPS,
                .tx_phys = BLE_GAP_PHY_2MBPS,
            };			
static void ble_evt_handler(ble_evt_t const * p_ble_evt, void * p_context)
{
    uint32_t err_code;
	 ble_gap_evt_t const * p_gap_evt = &p_ble_evt->evt.gap_evt;

    switch (p_ble_evt->header.evt_id)
    {
        case BLE_GAP_EVT_CONNECTED:
            NRF_LOG_INFO("Connected");
            err_code = bsp_indication_set(BSP_INDICATE_CONNECTED);
            APP_ERROR_CHECK(err_code);
            m_conn_handle = p_ble_evt->evt.gap_evt.conn_handle;
            err_code = nrf_ble_qwr_conn_handle_assign(&m_qwr, m_conn_handle);
            APP_ERROR_CHECK(err_code);
						/*主动要求更新PHY*/
						err_code = sd_ble_gap_phy_update(p_gap_evt->conn_handle, &phys);
nrf_drv_gpiote_in_event_enable(DRDY_PIN,true);
            break;

        case BLE_GAP_EVT_DISCONNECTED:
            NRF_LOG_INFO("Disconnected");
            // LED indication will be changed when advertising starts.
            m_conn_handle = BLE_CONN_HANDLE_INVALID;
//						APP_ERROR_CHECK(app_timer_stop(m_timer_speed));	
nrf_drv_gpiote_in_event_disable(DRDY_PIN);
						m_len_sent = 0;
						m_cnt_7ms = 0;
            break;

        case BLE_GAP_EVT_PHY_UPDATE_REQUEST:
        {
            NRF_LOG_DEBUG("PHY update request.");
            ble_gap_phys_t const phys =
            {
                .rx_phys = BLE_GAP_PHY_2MBPS,
                .tx_phys = BLE_GAP_PHY_2MBPS,
            };
            err_code = sd_ble_gap_phy_update(p_ble_evt->evt.gap_evt.conn_handle, &phys);
            APP_ERROR_CHECK(err_code);
        } break;

        case BLE_GAP_EVT_SEC_PARAMS_REQUEST:
            // Pairing not supported
            err_code = sd_ble_gap_sec_params_reply(m_conn_handle, BLE_GAP_SEC_STATUS_PAIRING_NOT_SUPP, NULL, NULL);
            APP_ERROR_CHECK(err_code);
            break;

        case BLE_GATTS_EVT_SYS_ATTR_MISSING:
            // No system attributes have been stored.
            err_code = sd_ble_gatts_sys_attr_set(m_conn_handle, NULL, 0, 0);
            APP_ERROR_CHECK(err_code);
            break;

        case BLE_GATTC_EVT_TIMEOUT:
            // Disconnect on GATT Client timeout event.
            err_code = sd_ble_gap_disconnect(p_ble_evt->evt.gattc_evt.conn_handle,
                                             BLE_HCI_REMOTE_USER_TERMINATED_CONNECTION);
            APP_ERROR_CHECK(err_code);
            break;

        case BLE_GATTS_EVT_TIMEOUT:
            // Disconnect on GATT Server timeout event.
            err_code = sd_ble_gap_disconnect(p_ble_evt->evt.gatts_evt.conn_handle,
                                             BLE_HCI_REMOTE_USER_TERMINATED_CONNECTION);
            APP_ERROR_CHECK(err_code);
            break;

        default:
            // No implementation needed.
            break;
    }
}


/**@brief Function for the SoftDevice initialization.
 *
 * @details This function initializes the SoftDevice and the BLE event interrupt.
 */
static void ble_stack_init(void)
{
    ret_code_t err_code;

    err_code = nrf_sdh_enable_request();
    APP_ERROR_CHECK(err_code);

    // Configure the BLE stack using the default settings.
    // Fetch the start address of the application RAM.
    uint32_t ram_start = 0;
    err_code = nrf_sdh_ble_default_cfg_set(APP_BLE_CONN_CFG_TAG, &ram_start);
    APP_ERROR_CHECK(err_code);

    // Enable BLE stack.
    err_code = nrf_sdh_ble_enable(&ram_start);
    APP_ERROR_CHECK(err_code);

    // Register a handler for BLE events.
    NRF_SDH_BLE_OBSERVER(m_ble_observer, APP_BLE_OBSERVER_PRIO, ble_evt_handler, NULL);
}


/**@brief Function for handling events from the GATT library. */
void gatt_evt_handler(nrf_ble_gatt_t * p_gatt, nrf_ble_gatt_evt_t const * p_evt)
{
    if ((m_conn_handle == p_evt->conn_handle) && (p_evt->evt_id == NRF_BLE_GATT_EVT_ATT_MTU_UPDATED))
    {
        m_ble_nus_max_data_len = p_evt->params.att_mtu_effective - OPCODE_LENGTH - HANDLE_LENGTH;
        NRF_LOG_INFO("Data len is set to 0x%X(%d)", m_ble_nus_max_data_len, m_ble_nus_max_data_len);
    }
    NRF_LOG_DEBUG("ATT MTU exchange completed. central 0x%x peripheral 0x%x",
                  p_gatt->att_mtu_desired_central,
                  p_gatt->att_mtu_desired_periph);
}


/**@brief Function for initializing the GATT library. */
void gatt_init(void)
{
    ret_code_t err_code;

    err_code = nrf_ble_gatt_init(&m_gatt, gatt_evt_handler);
    APP_ERROR_CHECK(err_code);

    err_code = nrf_ble_gatt_att_mtu_periph_set(&m_gatt, NRF_SDH_BLE_GATT_MAX_MTU_SIZE);
    APP_ERROR_CHECK(err_code);
}


/**@brief Function for handling events from the BSP module.
 *
 * @param[in]   event   Event generated by button press.
 */
void KeyExit_pin_init(void);
void bsp_event_handler(bsp_event_t event)
{
    uint32_t err_code;
    switch (event)
    {
        case BSP_EVENT_SLEEP:
					bsp_indication_set(BSP_INDICATE_IDLE);
					bsp_board_led_on(BSP_BOARD_LED_2);//亮红灯提示关机
					KeyExit_pin_init();//配置关机引脚中断，进入休眠
//            sleep_mode_enter();
            break;

        case BSP_EVENT_DISCONNECT:
            err_code = sd_ble_gap_disconnect(m_conn_handle, BLE_HCI_REMOTE_USER_TERMINATED_CONNECTION);
            if (err_code != NRF_ERROR_INVALID_STATE)
            {
                APP_ERROR_CHECK(err_code);
            }
            break;

        case BSP_EVENT_WHITELIST_OFF:
            if (m_conn_handle == BLE_CONN_HANDLE_INVALID)
            {
                err_code = ble_advertising_restart_without_whitelist(&m_advertising);
                if (err_code != NRF_ERROR_INVALID_STATE)
                {
                    APP_ERROR_CHECK(err_code);
                }
            }
            break;

        default:
            break;
    }
}



#define TX_POWER_LEVEL                  (4)

/**@brief Function for initializing the Advertising functionality.
 */
static void advertising_init(void)
{
    uint32_t               err_code;
    ble_advertising_init_t init;
		int8_t        tx_power_level = TX_POWER_LEVEL;//设置发射功率
    memset(&init, 0, sizeof(init));

    init.advdata.name_type          = BLE_ADVDATA_FULL_NAME;
    init.advdata.include_appearance = false;
    init.advdata.flags              = BLE_GAP_ADV_FLAGS_LE_ONLY_GENERAL_DISC_MODE;
		init.advdata.p_tx_power_level        = &tx_power_level;
	
    init.srdata.uuids_complete.uuid_cnt = sizeof(m_adv_uuids) / sizeof(m_adv_uuids[0]);
    init.srdata.uuids_complete.p_uuids  = m_adv_uuids;

    init.config.ble_adv_fast_enabled  = true;
    init.config.ble_adv_fast_interval = APP_ADV_INTERVAL;
    init.config.ble_adv_fast_timeout  = APP_ADV_DURATION;
    init.evt_handler = on_adv_evt;

    err_code = ble_advertising_init(&m_advertising, &init);
    APP_ERROR_CHECK(err_code);

    ble_advertising_conn_cfg_tag_set(&m_advertising, APP_BLE_CONN_CFG_TAG);
}


/**@brief Function for initializing buttons and leds.
 *
 * @param[out] p_erase_bonds  Will be true if the clear bonding button was pressed to wake the application up.
 */
static void buttons_leds_init(bool * p_erase_bonds)
{
    bsp_event_t startup_event;

    uint32_t err_code = bsp_init(BSP_INIT_LEDS | BSP_INIT_BUTTONS, bsp_event_handler);
    APP_ERROR_CHECK(err_code);

    err_code = bsp_btn_ble_init(NULL, &startup_event);
    APP_ERROR_CHECK(err_code);

    *p_erase_bonds = (startup_event == BSP_EVENT_CLEAR_BONDING_DATA);
}


/**@brief Function for initializing the nrf log module.
 */
static void log_init(void)
{
    ret_code_t err_code = NRF_LOG_INIT(NULL);
    APP_ERROR_CHECK(err_code);

    NRF_LOG_DEFAULT_BACKENDS_INIT();
}


/**@brief Function for initializing power management.
 */
static void power_management_init(void)
{
    ret_code_t err_code;
    err_code = nrf_pwr_mgmt_init();
    APP_ERROR_CHECK(err_code);
}


/**@brief Function for handling the idle state (main loop).
 *
 * @details If there is no pending log operation, then sleep until next the next event occurs.
 */
static void idle_state_handle(void)
{
    if (NRF_LOG_PROCESS() == false)
    {
        nrf_pwr_mgmt_run();
    }
}

/*DFU新增*/
/** @brief Clear bonding information from persistent storage.
 */
static void delete_bonds(void)
{
    ret_code_t err_code;

    NRF_LOG_INFO("Erase bonds!");

    err_code = pm_peers_delete();
    APP_ERROR_CHECK(err_code);
}

/**@brief Function for handling Peer Manager events.
 *
 * @param[in] p_evt  Peer Manager event.
 */
static void pm_evt_handler(pm_evt_t const * p_evt)
{
    pm_handler_on_pm_evt(p_evt);
    pm_handler_disconnect_on_sec_failure(p_evt);
    pm_handler_flash_clean(p_evt);
}

/**@brief Function for the Peer Manager initialization.
 */
static void peer_manager_init()
{
    ble_gap_sec_params_t sec_param;
    ret_code_t           err_code;

    err_code = pm_init();
    APP_ERROR_CHECK(err_code);

    memset(&sec_param, 0, sizeof(ble_gap_sec_params_t));

    // Security parameters to be used for all security procedures.
    sec_param.bond           = SEC_PARAM_BOND;
    sec_param.mitm           = SEC_PARAM_MITM;
    sec_param.lesc           = SEC_PARAM_LESC;
    sec_param.keypress       = SEC_PARAM_KEYPRESS;
    sec_param.io_caps        = SEC_PARAM_IO_CAPABILITIES;
    sec_param.oob            = SEC_PARAM_OOB;
    sec_param.min_key_size   = SEC_PARAM_MIN_KEY_SIZE;
    sec_param.max_key_size   = SEC_PARAM_MAX_KEY_SIZE;
    sec_param.kdist_own.enc  = 1;
    sec_param.kdist_own.id   = 1;
    sec_param.kdist_peer.enc = 1;
    sec_param.kdist_peer.id  = 1;

    err_code = pm_sec_params_set(&sec_param);
    APP_ERROR_CHECK(err_code);

    err_code = pm_register(pm_evt_handler);
    APP_ERROR_CHECK(err_code);
}

/**@brief Function for starting advertising.
 */
static void advertising_start(bool erase_bonds)
{
    if (erase_bonds == true)
    {
        delete_bonds();
        // Advertising is started by PM_EVT_PEERS_DELETE_SUCCEEDED event.
    }
    else
    {
        uint32_t err_code = ble_advertising_start(&m_advertising, BLE_ADV_MODE_FAST);
        APP_ERROR_CHECK(err_code);

        NRF_LOG_DEBUG("advertising is started");
    }
}

/**
*连接事件长度扩展
*/
void conn_evt_len_ext_set(void)
{
    ret_code_t err_code;
    ble_opt_t  opt;

    memset(&opt, 0x00, sizeof(opt));
    opt.common_opt.conn_evt_ext.enable = true;

    err_code = sd_ble_opt_set(BLE_COMMON_OPT_CONN_EVT_EXT, &opt);
    APP_ERROR_CHECK(err_code);

}

/**
*队列有数据就调用BLE发送，以及重发
*/
buffer_t m_buf;
void ble_data_send_with_queue(void)
{
	uint32_t err_code;
	uint16_t length = 0;
	static bool retry = false;
	
	if (retry)
	{
		length = m_buf.length;
		err_code = ble_nus_data_send(&m_nus, m_buf.p_data, &length, m_conn_handle);

		if (err_code == BLE_ERROR_GATTS_SYS_ATTR_MISSING){
				uint32_t err_code = sd_ble_gatts_sys_attr_set(m_conn_handle, NULL, 0, 0);
				APP_ERROR_CHECK(err_code);
				NRF_LOG_INFO("Case 1: Notification Disabled ===================================");
		}		
		else if ( (err_code != NRF_ERROR_INVALID_STATE) && (err_code != NRF_ERROR_RESOURCES) &&
				 (err_code != NRF_ERROR_NOT_FOUND) )
		{
				APP_ERROR_CHECK(err_code);
		}

		if (err_code == NRF_SUCCESS)
		{
			m_len_sent += length;
			retry = false;
		}
	}
	
	while (!nrf_queue_is_empty(&m_buf_queue) && !retry)
	{		

		err_code = nrf_queue_pop(&m_buf_queue, &m_buf);
		APP_ERROR_CHECK(err_code);		
		length = m_buf.length;
					
		err_code = ble_nus_data_send(&m_nus, m_buf.p_data, &length, m_conn_handle);
		//NRF_LOG_INFO("Data: %d", m_buf.p_data[0]);
		if ( (err_code != NRF_ERROR_INVALID_STATE) && (err_code != NRF_ERROR_RESOURCES) &&
				 (err_code != NRF_ERROR_NOT_FOUND) )
		{
				APP_ERROR_CHECK(err_code);
		}
		if (err_code == NRF_SUCCESS)
		{
			m_len_sent += length;
			retry = false;
		}
		else
		{
			retry = true;
			break;
		}
	}			
}

/**
*1-测试用生成的数据
*/
static void throughput_timer_handler(void * p_context)
{
	ret_code_t err_code1, err_code2;	
	buffer_t buf;
	static uint8_t val = 0;
	//produce the data irregard of BLE activity
	m_data_array[(m_cnt_7ms%10)*420] = val++;
	m_data_array[(m_cnt_7ms%10)*420+210] = val++;
	
	//put the data into a queue to cache them
	buf.p_data = &m_data_array[(m_cnt_7ms%10)*420];
	buf.length = MIN(m_ble_nus_max_data_len,210);
	err_code1 = nrf_queue_push(&m_buf_queue, &buf);
	//APP_ERROR_CHECK(err_code1); //it may return NRF_ERROR_NO_MEM. we skip this error
	
	buf.p_data = &m_data_array[(m_cnt_7ms%10)*420+210];
	buf.length = MIN(m_ble_nus_max_data_len,210);
	err_code2 = nrf_queue_push(&m_buf_queue, &buf);
	//APP_ERROR_CHECK(err_code2);	//it may return NRF_ERROR_NO_MEM. we skip this error
	
	ble_data_send_with_queue();
	
	if(err_code1 == NRF_ERROR_NO_MEM || err_code2 == NRF_ERROR_NO_MEM)
	{
		NRF_LOG_INFO("Drop");	
	}
	
	m_cnt_7ms++;	
	//calculate speed every 1 second
	if (m_cnt_7ms == 50)
	{
		NRF_LOG_INFO("==**Speed: %d B/s**==", m_len_sent);
		m_cnt_7ms = 0;
		m_len_sent = 0;
	}	
}

/**
*2-ADS1299生成的数据
*/
extern uint8_t eCon_Message[240];
void  data_prepare()
{
	ret_code_t err_code;
	buffer_t buf;	
	memcpy(&m_data_array[(m_cnt_7ms)*220],eCon_Message,220);
	buf.p_data = &m_data_array[(m_cnt_7ms)*220];
	buf.length = 220;
	err_code = nrf_queue_push(&m_buf_queue, &buf);
	
	ble_data_send_with_queue();
	
	if(err_code == NRF_ERROR_NO_MEM)
	{
//		NRF_LOG_INFO("Drop");	
	}	
	
	m_cnt_7ms++;
	if (m_cnt_7ms == 20){
		NRF_LOG_INFO("==**Speed: %d B/s**==", m_len_sent*3);
		m_cnt_7ms = 0;
		m_len_sent = 0;
	
	}
}

/**
*数据发送压力测试用
*/
void throughput_test()
{
	ret_code_t err_code;
	err_code = app_timer_create(&m_timer_speed, APP_TIMER_MODE_REPEATED, throughput_timer_handler);
	APP_ERROR_CHECK(err_code);
}




#include "ADS1299_Library.h"

/*
	检测充电器拔出与充满
*/
uint8_t FullyCharge_count = 0;
void ChargerUnplug_or_FullyCharged(void)
{
		ret_code_t err_code;
			/*充电时读取VCHECK引脚，检测充电器拔出*/
		if(nrf_gpio_pin_read(CHARGE_VCHECK_PIN) == 0) {
			sleep_mode_enter();
		}
		/*充电时读取STA引脚，检测是否充满*/
		if((nrf_gpio_pin_read(CHARGE_STA_PIN) == 1) && (nrf_gpio_pin_read(CHARGE_VCHECK_PIN) == 1)) {
			FullyCharge_count++;
			if(FullyCharge_count == 5) {
				bsp_indication_set(BSP_INDICATE_USER_STATE_1);//充满绿灯常亮
			}						
		}
		/**/
		if(DevicePara.adv_started == true) {//广播已经启动
		  err_code = sd_ble_gap_adv_stop(m_advertising.adv_handle);
		  if(err_code == NRF_SUCCESS)
		  {
			  DevicePara.adv_started = false;
			  //调整指示灯
				bsp_board_leds_off();
				bsp_indication_set(BSP_INDICATE_USER_STATE_3);//充电红灯闪烁
		  }
		}
				
}

/*
	打开充电定时器
*/
void charging_timer_start(void)
{
	app_timer_start(charging_timer, APP_TIMER_TICKS(500),NULL);
}

/*
	充电定时器函数，500ms进入一次
*/
static void charging_timer_handler(void * p_context)
{
	ChargerUnplug_or_FullyCharged();
}

/*
	打开系统检测函数
*/
void system_task_timer_start(void)
{
	app_timer_start(system_task_timer, APP_TIMER_TICKS(500),NULL);
}
/*
	关闭系统检测函数
*/
void system_task_timer_stop(void)
{
	app_timer_stop(system_task_timer);
}
/*
	系统检测函数，500ms进入一次
*/
static void system_task_timer_handler(void * p_context)
{
	if(RXbuff[0]) {
		system_task_timer_stop();
		ADS_state_choose(RXbuff[0]);
		memset(RXbuff,0,sizeof(RXbuff));
		system_task_timer_start();
	}
	if(m_conn_handle != BLE_HCI_STATUS_CODE_SUCCESS){//蓝牙未建立连接
		ADS_SDATAC();//停止连续读模式
		ADS_STANDBY();//进入低功耗模式		
	}
}

/**@brief Function for initializing the timer module.
 */
static void timers_init(void)
{
    ret_code_t err_code = app_timer_init();
    APP_ERROR_CHECK(err_code);
	
		err_code = app_timer_create(&charging_timer, APP_TIMER_MODE_REPEATED, charging_timer_handler);
		APP_ERROR_CHECK(err_code);
	
		err_code = app_timer_create(&system_task_timer, APP_TIMER_MODE_REPEATED, system_task_timer_handler);
		APP_ERROR_CHECK(err_code);
}
/*
	引脚中断函数
*/
void in_pin_handler(nrf_drv_gpiote_pin_t pin, nrf_gpiote_polarity_t action)
{
	ret_code_t err_code;

	if(pin == DRDY_PIN){
		updateBoardData();		
	}
	if(pin == CHARGE_VCHECK_PIN){
		if(m_conn_handle == BLE_HCI_STATUS_CODE_SUCCESS) {//连接已经建立
			err_code = sd_ble_gap_disconnect(m_conn_handle, BLE_HCI_REMOTE_USER_TERMINATED_CONNECTION);//断开蓝牙连接
			APP_ERROR_CHECK(err_code);
		}
		if((DevicePara.adv_started == true) && (m_conn_handle == BLE_CONN_HANDLE_INVALID)) {//连接未建立，广播已经启动
			err_code = sd_ble_gap_adv_stop(m_advertising.adv_handle);
			if(err_code == NRF_SUCCESS)
			{
				DevicePara.adv_started = false;
			}

		}
		//调整指示灯
		bsp_board_leds_off();
		bsp_indication_set(BSP_INDICATE_USER_STATE_3);//充电红灯闪烁
		//打开定时器
		charging_timer_start();
	}
	if(pin == KEY_EXIT_PIN){
		sleep_mode_enter();
	}		
}

/*
	DRDY引脚中断配置
*/
void drdy_pin_init(void)
{
	ret_code_t err_code;

//	err_code = nrf_drv_gpiote_init();//bsp_init()已经初始化GPIOTE
//	APP_ERROR_CHECK(err_code);
	//配置SENSE模式，选择fales为sense配置
	nrf_drv_gpiote_in_config_t in_config = NRFX_GPIOTE_CONFIG_IN_SENSE_HITOLO(true);
	in_config.pull = NRF_GPIO_PIN_NOPULL;	
	//配置INT-KEY绑定POTR
	err_code = nrf_drv_gpiote_in_init(DRDY_PIN, &in_config, in_pin_handler);
	APP_ERROR_CHECK(err_code);
	//使能
//	nrf_drv_gpiote_in_event_enable(DRDY_PIN, true);
}

/*
	充电引脚中断配置
*/
void Vcheck_pin_init(void)
{
	ret_code_t err_code;
	//配置SENSE模式，选择fales为sense配置
	nrf_drv_gpiote_in_config_t in_config = NRFX_GPIOTE_CONFIG_IN_SENSE_LOTOHI(true);
	in_config.pull = NRF_GPIO_PIN_NOPULL;	
	//配置INT-KEY绑定POTR
	err_code = nrf_drv_gpiote_in_init(CHARGE_VCHECK_PIN, &in_config, in_pin_handler);
	APP_ERROR_CHECK(err_code);
	//使能
	nrf_drv_gpiote_in_event_enable(CHARGE_VCHECK_PIN,true);

}

/*
	关机引脚中断配置
*/
void KeyExit_pin_init(void)
{
//	nrf_gpio_cfg_default(KEY_EXIT_PIN);
	nrfx_gpiote_in_uninit(KEY_EXIT_PIN);
	ret_code_t err_code;
	//配置SENSE模式，选择fales为sense配置
	nrf_drv_gpiote_in_config_t in_config = NRFX_GPIOTE_CONFIG_IN_SENSE_LOTOHI(false);
	in_config.pull = NRF_GPIO_PIN_NOPULL;	
	//配置INT-KEY绑定POTR
	err_code = nrf_drv_gpiote_in_init(KEY_EXIT_PIN, &in_config, in_pin_handler);
	APP_ERROR_CHECK(err_code);
	//使能
	nrf_drv_gpiote_in_event_enable(KEY_EXIT_PIN,true);	
}

/**
*蓝牙发射功率设置
*/
static void tx_power_set(void)
{
    ret_code_t err_code = sd_ble_gap_tx_power_set(BLE_GAP_TX_POWER_ROLE_ADV, m_advertising.adv_handle, TX_POWER_LEVEL);
    APP_ERROR_CHECK(err_code);
}



/**@brief Application main function.
 */
int main(void)
{
    bool erase_bonds;
    // Initialize.
    log_init();	//log打印初始化
    timers_init();//软件定时器初始化
		Device_Para_Init(&DevicePara);
/*3V3电源打开*/
    cpc_ldo1_enable();
/*5v电源打开*/
		AVDD_enable();
/*ADS1292的gpio初始化*/	
		nrf_gpio_cfg_output(SPI_SS_PIN);//SPI_SS_PIN
		nrf_gpio_cfg_output(ADS_START_PIN);//ADS_START
		nrf_gpio_cfg_output(ADS_RESET_PIN);//ADS_RESET
		nrf_gpio_cfg_output(ADS_PWDN_PIN);//ADS_PWDN
		
		nrf_gpio_pin_set(SPI_SS_PIN);//CS高电平
		nrf_gpio_pin_set(ADS_PWDN_PIN);//PWDN高电平
		nrf_gpio_pin_set(ADS_RESET_PIN);//RESET高电平
		nrf_gpio_pin_clear(ADS_START_PIN);//START低电平	
		
		SPI_User_init();
		initialize_ads(SAMPLE_RATE_500);
		ADS_STANDBY();//进入低功耗模式

/*充电引脚初始化*/	
		ChargerPin_Init();
	
    buttons_leds_init(&erase_bonds);//按键LED灯初始化
    power_management_init();//能量管理
    ble_stack_init();	//协议栈初始化
		peer_manager_init();
    gap_params_init();//GAP初始化
    gatt_init();//GATT初始化
    services_init();//服务初始化
    advertising_init();//广播初始化
    conn_params_init();//连接参数更新初始化

/*配置DRDY引脚中断*/
		drdy_pin_init();
/*充电还是按键开机*/		
		nrf_delay_ms(50);
		uint8_t setupcheck = 0;
		setupcheck = nrf_gpio_pin_read(CHARGE_VCHECK_PIN);
		if(setupcheck==1) {//充电器插入唤醒
			bsp_indication_set(BSP_INDICATE_USER_STATE_3);//充电红灯闪烁
			charging_timer_start();
			for(;;);
		}

/*充电引脚中断配置*/
		Vcheck_pin_init();
/*系统指令接收定时器*/
		system_task_timer_start();

		conn_evt_len_ext_set();//连接事件长度扩展
    // Start execution.
		tx_power_set();//设置发送功率
    advertising_start(erase_bonds);//开始广播
		

//		throughput_test();
    // Enter main loop.
    for (;;)
    {
        idle_state_handle();
    }
}


/**
 * @}
 */
