SeerLikeJazz/Libuart-peripheral-EEG/(commit log)

2022-09-27 定时器20ms发送，phy 2M
2022-09-27 暂存，ads1299暂时无法读取数据
2022-09-27 暂存，断开后重连会error
2022-09-30 解决-断开后再重连nus 0x3401 error
2022-10-12 NFC引脚设置为普通GPIO模式
2022-10-27 休眠，7uA
2022-10-30 添加driver_power.c
2022-10-31 充电器插入唤醒
2022-11-02 充电器插入检测、充满检测
2022-11-02 定时器检测充电器的拔出与充满
2022-11-03 22.11.03暂存
2022-11-03 充电时，停止连接和广播
2022-11-16 fix：蓝牙连接后长按无法关机
2022-11-20 增加DFU服务
2022-11-20 fix：增加DFU服务后，无法按键关机
2022-11-21 ### 22.11.21-暂存
2022-11-21 增加STANDBY和WAKEUP指令,降低开机非工作状态时功耗
2022-11-22 设置发送功率+4dBm，添加RSSI测试工程
2022-11-23 整理程序注释，优化函数
2022-12-19 ### 22.12.19-fix:Z发送后W运行不对
